dkwdaft/blockly_accessible_switch_interface/STL/TFT Switch Interface Case/Adafruit Remix Case- Working Files/Blockly Adafruit btm V2.stl

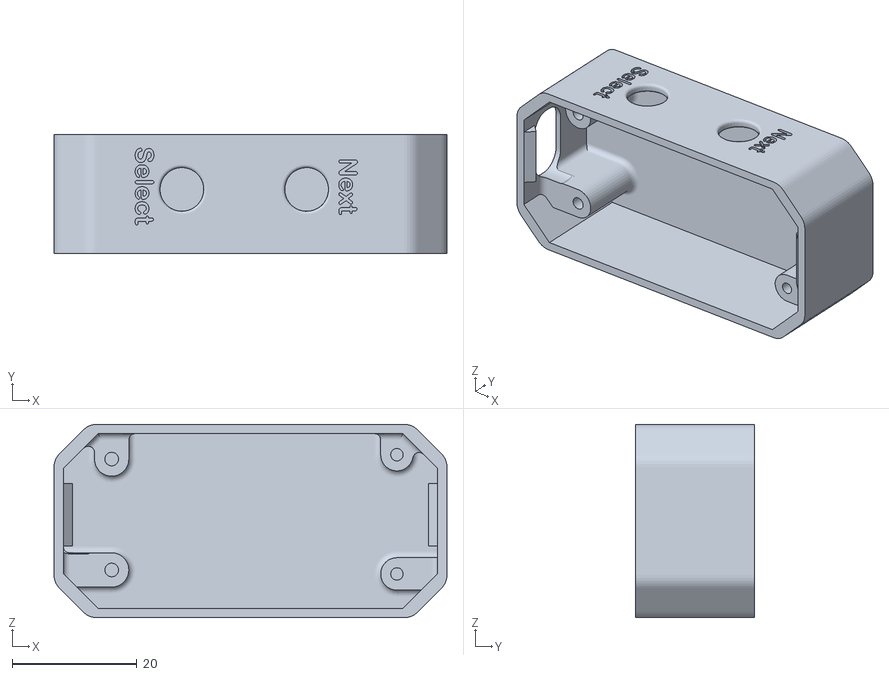
[picture p1: CAD file, 2026-06-02]
STL/TFT Switch Interface Case/Adafruit Remix Case- Working Files/Blockly Adafruit btm V2.stl
63.0 x 19.1 x 31.0
