dkwdaft/blockly_accessible_switch_interface/STL/TFT Switch Interface Case/Adafruit Remix Case- Working Files/Blockly Adafruit btm.3mf

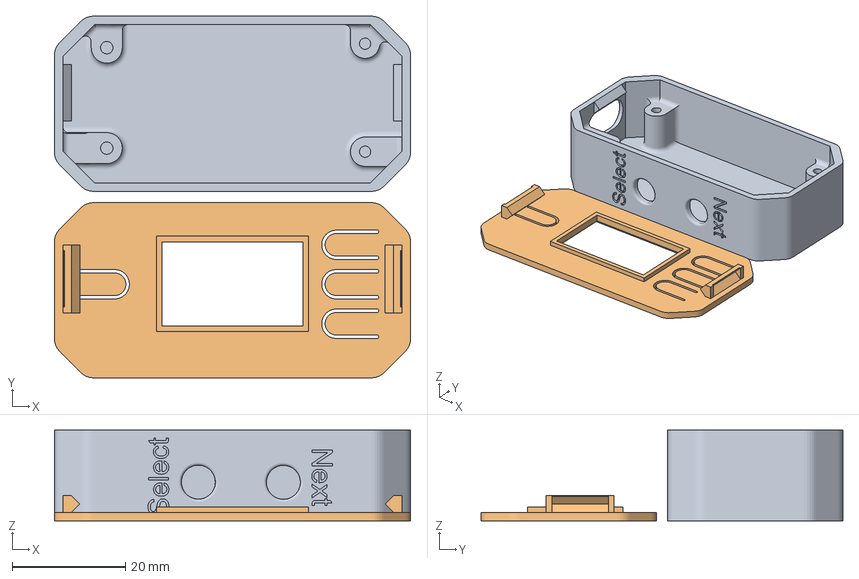
[picture p2: CAD file, 2026-06-02]
STL/TFT Switch Interface Case/Adafruit Remix Case- Working Files/Blockly Adafruit btm.3mf
63.0 x 64.0 x 16.1 mm
Blockly Adafruit btm.stl
Blockly Adafruit top.stl
