dkwdaft/blockly_accessible_switch_interface/STL/TFT Switch Interface Case/Adafruit Remix Case- Working Files/Blockly Adafruit top.stl

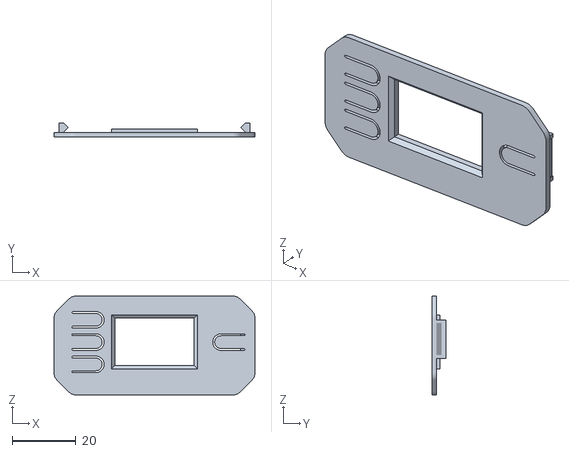
[picture p3: CAD file, 2026-05-27]
STL/TFT Switch Interface Case/Adafruit Remix Case- Working Files/Blockly Adafruit top.stl
63.0 x 4.50 x 31.0
