dkwdaft/blockly_accessible_switch_interface/STL/TFT Switch Interface Case/Blockly Interface Top.stl

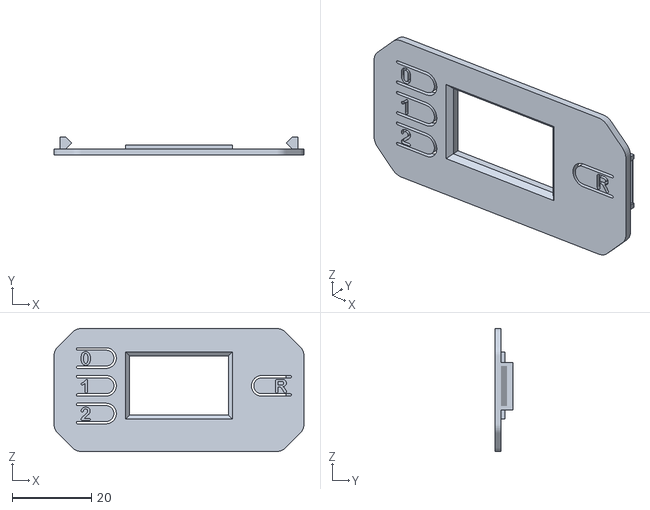
[picture p4: CAD file, 2026-06-02]
STL/TFT Switch Interface Case/Blockly Interface Top.stl
63.0 x 4.50 x 31.0
