dkwdaft/blockly_accessible_switch_interface/STL/TFT Switch Interface Case/Adafruit Remix Case- Working Files/TFT Case Bottom.stl

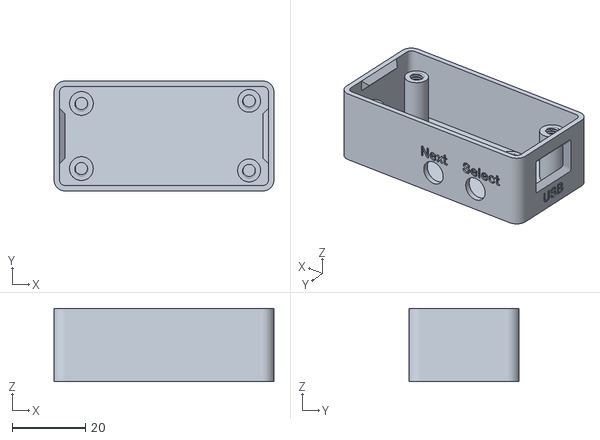
[picture p5: CAD file, 2026-05-27]
STL/TFT Switch Interface Case/Adafruit Remix Case- Working Files/TFT Case Bottom.stl
60.0 x 30.0 x 20.0
