dkwdaft/blockly_accessible_switch_interface/STL/TFT Switch Interface Case/Adafruit Remix Case- Working Files/TFT Case Top.stl

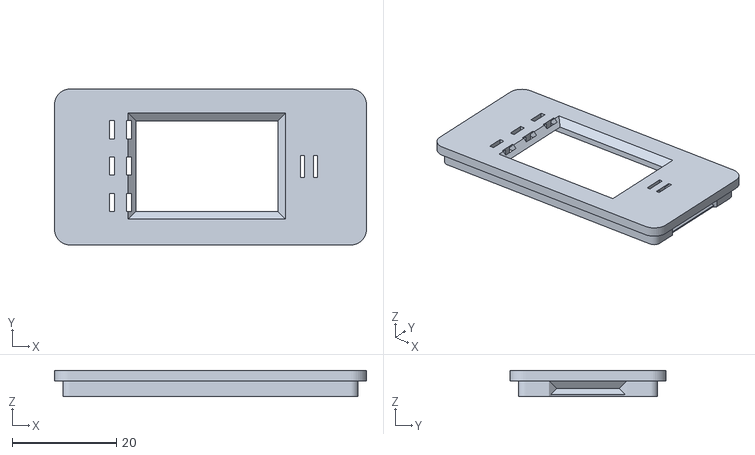
[picture p6: CAD file, 2026-05-27]
STL/TFT Switch Interface Case/Adafruit Remix Case- Working Files/TFT Case Top.stl
60.0 x 30.0 x 5.00
