dkwdaft/blockly_accessible_switch_interface/(list of files, cad)

Other CAD files:
STL/TFT Switch Interface Case/Blockly Interface Case.step
STL/TFT Switch Interface Case/Blockly Interface Bottom.stl
STL/TFT Switch Interface Case/Adafruit Remix Case- Working Files/Blockly Adafruit btm.stl
STL/TFT Switch Interface Case/Blockly Interface Case.f3z
