dkwdaft/blockly_accessible_switch_interface/docs/build.html

Skip to main content

Step-by-step guide

# Build Instructions

Everything you need to assemble, wire, and install firmware — from parts list to first boot.

Watch the video walkthrough ↓ View Google Slide Instructions (https://docs.google.com/presentation/d/e/2PACX-1vRLB-ssaZ2lQKfzIOw7MU3ilnS_D7XAcPhWdcv4CS0tsQ7e1NFE6QulaQyW4kVeWO49AM5KeUvafYBN/pub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)

Step 01

## Parts List

Gather the following components. All parts are available from Adafruit, Digi-Key, or similar suppliers.

Component | Details | Notes
Adafruit Feather ESP32-S3 Rev TFT | #5691 (https://www.adafruit.com/product/5691) | Built-in 240×135 TFT display
3.5mm Stereo Jack Breakout (×2) | TRRS or TRS, panel-mount | For A1 (nav) and A2 (select)
Accessibility switches (×1 or ×2) | Any 3.5mm momentary assistive switch | Wired to GND, normally open
Small enclosure | Any project box ≥ 80×50mm or 3D printed files (https://www.printables.com/model/1533483-blockly-switch-interface) | 3D print or off-the-shelf
USB-C cable | Data-capable | For firmware install and USB HID

ℹ The Feather has onboard D0, D1, and D2 buttons for mode selection — no extra buttons needed.

Step 02

## Wiring & Pin Connections

Both switch inputs use internal pull-up resistors — a pressed switch reads LOW (False).

Pin | Role | Wiring | Logic
A1 | Navigate switch | Tip → A1, Sleeve → GND | Active LOW (Pull.UP)
A2 | Select / Single switch | Tip → A2, Sleeve → GND | Active LOW (Pull.UP)
GND | Ground reference | Sleeve of both jacks | –
D0 | Onboard — Direct Switch Interface | Built-in button | Active LOW (Pull.UP)
D1 | Onboard — single-switch mode | Built-in button | Active HIGH (Pull.DOWN)
D2 | Onboard — two-switch mode | Built-in button | Active HIGH (Pull.DOWN)

⚠ Do not apply voltage to A1 or A2 — digital input only. Use normally-open switches wired to GND.

Step 03

## Install CircuitPython

✓ Your board may require installation of the TinyUF2 bootloader. Follow the instructions on the Adafruit Learn Guide (https://learn.adafruit.com/esp32-s3-reverse-tft-feather/update-tinyuf2-bootloader-for-circuitpython-10-4mb-boards-only).

The firmware requires CircuitPython 10 or later.

1. Download the latest .UF2 for Feather ESP32-S3 Rev TFT from circuitpython.org (https://circuitpython.org/board/adafruit_feather_esp32s3_reverse_tft/).
2. Enter bootloader by clicking the RESET button— the drive FTHRS3BOOT appears.
3. Drag and drop the .UF2 file onto FTHRS3BOOT. The board reboots automatically.
4. A drive named CIRCUITPY appears — you're ready to copy files.

Step 04

## Install Libraries

Copy these from the CircuitPython Library Bundle (https://circuitpython.org/libraries) into the lib/ folder on CIRCUITPY:

1. adafruit_st7789 — TFT display driver
2. adafruit_display_text — on-screen labels
3. adafruit_hid — USB HID keyboard emulation

CIRCUITPY/ ├── code.py ├── config.py # optional — generated by configurator └── lib/ ├── adafruit_st7789.mpy ├── adafruit_display_text/ └── adafruit_hid/

Step 05

## Install Firmware Files

Download code.py from the GitHub repository (https://github.com/loretod/blockly_accessible_switch_interface) and copy it to the root of CIRCUITPY. It runs automatically on every boot.

Video walkthrough

ℹ Do not rename code.py — CircuitPython runs this filename on boot. Place config.py alongside it to override defaults (see Step 6).

Step 06

## Configuration (optional)

Without a config.py the device uses built-in defaults. To customise:

1. Open the Shortcut Configurator in your browser.
2. Select your OS and adjust shortcuts and timing as needed.
3. Click Generate config.py then Download config.py.
4. Copy the file to the root of CIRCUITPY — the device reloads automatically.

The import block in code.py (placed after KEYCODES / KEY_SYMBOLS):

try: from config import * except ImportError: pass # config.py missing — use defaults above

✓ Video walkthrough available (https://www.youtube.com/watch?v=kUqRWDpYum8)

Step 07

## First Boot

Power via USB. The TFT shows the mode-select screen with three zones:

- Left — D0 — Direct Switch Mode (Mode 0)
- Centre — D1 / A2 — Single-switch scanning mode
- Right — D2 / A1 — Two-switch direct mode

Press the relevant onboard button or external switch to enter a mode. To return to the mode-select screen, press the board's RESET button. In Mode 0 you can also hold an external switch for 1.5 s to exit (useful when the onboard buttons aren't reachable).

ℹ Can't reach the onboard D0 button? Double-click either external switch (A1 or A2) at the mode-select screen to jump straight into Mode 0 — Direct Switch.

Step 08

## Switch Modes Reference

### Single-Switch (A2)

One switch controls everything — short press to select, hold to auto-scan.

Short pressSelect & send current item

Hold (2s)Start auto-scanning

Press during scanSelect, stop scanning

D0Return to mode select

### Two-Switch (A1 + A2)

Separate navigate and select switches for faster, direct control.

A1 pressAdvance to next item

A2 pressSelect & send current item

D0Return to mode select

ℹ Single-switch and two-switch modes can also be selected at startup with the external switches: A2 (select) for single-switch mode, A1 (nav) for two-switch mode. To leave any mode, press the board's RESET button (Mode 0 can also be exited by holding a switch).

Mode 0

## Direct Switch Mode

Mode 0 maps each external switch directly to a single, immediate action — no scanning or navigation required. It is designed for users who need a simple, low-effort input method or who want to control mouse and media functions with their switches.

### Direct Switch (Mode 0)

Each switch fires one action immediately on press. Default: Switch 1 = Enter, Switch 2 = Tab. Fully configurable in the Shortcut Configurator.

A1 tapSwitch 1 action (default: Enter)

A2 tapSwitch 2 action (default: Tab)

A1/A2 hold (1.5 s)Return to mode select

RESET buttonReturn to mode select

### How to enter Mode 0

Method | How | Best for
D0 | Press onboard D0 button at mode-select screen | Initial setup, tester access
Double-click | Double-click either external switch (A1 or A2) at the mode-select screen within 0.4 s | Users who cannot reach onboard buttons
config.py | Run run_direct_switch_mode() as the first call in the main loop | Dedicated single-purpose device

ℹ Because a single external-switch click waits briefly (the double-click window, default 0.4 s) to watch for a second click, entering single- or two-switch mode via an external switch has a short deliberate delay. The onboard D1 / D2 buttons enter those modes instantly.

### How to exit Mode 0

Method | How | Best for
Hold a switch | Hold A1 or A2 for 1.5 s — a short tap still fires the action, only a long hold exits | Users who entered by double-click
RESET | Press the board's onboard RESET button | When the board is reachable

### Supported action types

Type | What it does | Example
Keyboard key | Press (and release) any key or key combo | Enter, Tab, Ctrl+C, Cmd+Space
Mouse click | Left, right, or middle button click | Left click for activation
Mouse scroll | Scroll up or down by N ticks per press | Scroll down a page
Mouse move | Move pointer by X/Y pixels per press | Nudge cursor right
Media control | Play/pause, volume, track skip, mute, brightness | Play/pause music

ℹ Customise both switch actions in the Shortcut Configurator under Mode 0 — Direct Switch Actions, then download and drop the generated config.py onto your device.

Step 09

## Display (optional)

The Feather ESP32-S3 TFT has a small built-in display that shows the active shortcut, next shortcut and connection status. Users with low vision may benefit from the Display Tool as an alternative to the small onboard screen. The web app tool provides a larger, high contrast, more readable interface for displaying information and text to speech support if enabled.

Watch the walkthrough below for a live demo of the display in action.

✓ Note: This tool is only support by Chrome or Edge browsers that support WebUSB. TTS is only supported on computers. This tool has not yet been tested on mobile devices.

BASI.

Open source — Creative Commons CC BY-SA 4.0
