dkwdaft/blockly_accessible_switch_interface/(commit log)

2026-05-27 Web config and Switch mode select
    Added working file for Adafruit based case, added web configuration file, added functionality of using switch to select desired mode during start up.
    [Blockly Adafruit btm.stl, Blockly Adafruit top.stl, Blockly Switch Interface.f3z, Blockly Switch Interface.step, TFT Case Bottom V3.stl, TFT Case Bottom.stl, TFT Case Top.stl]
2026-06-02 3D printed and configurator video
    Added new 3D printed case files based on Adafruit's Star Trek Data Dispenser file. Added how to configurator video link and clarified build instructions.
    [Blockly Adafruit btm V2.stl, Blockly Adafruit btm.3mf, Blockly Interface Bottom.stl, Blockly Interface Case.f3z, Blockly Interface Case.step, Blockly Interface Top.stl, Blockly Switch Interface.f3z, Blockly Switch Interface.step]
2026-06-13 Added Mode 0 for direct switch interface. Updated configurator and use instructions to reflect mode.
